arthurgritzky/Greifer/Dokumentation/Auslegung Greifer.pdf

# Auslegung Greifer

Aufgabe

Ein Roboter soll Werkstücke von dem Pufferförderband auf zwei Förderbänder einer Produktionsanlage aufteilen wie in Abbildung 1. skizziert wurde.

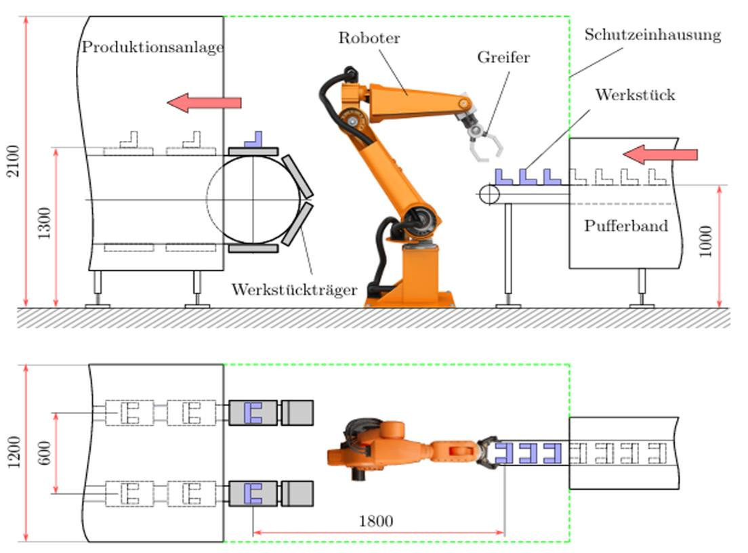
[picture p6: figure]
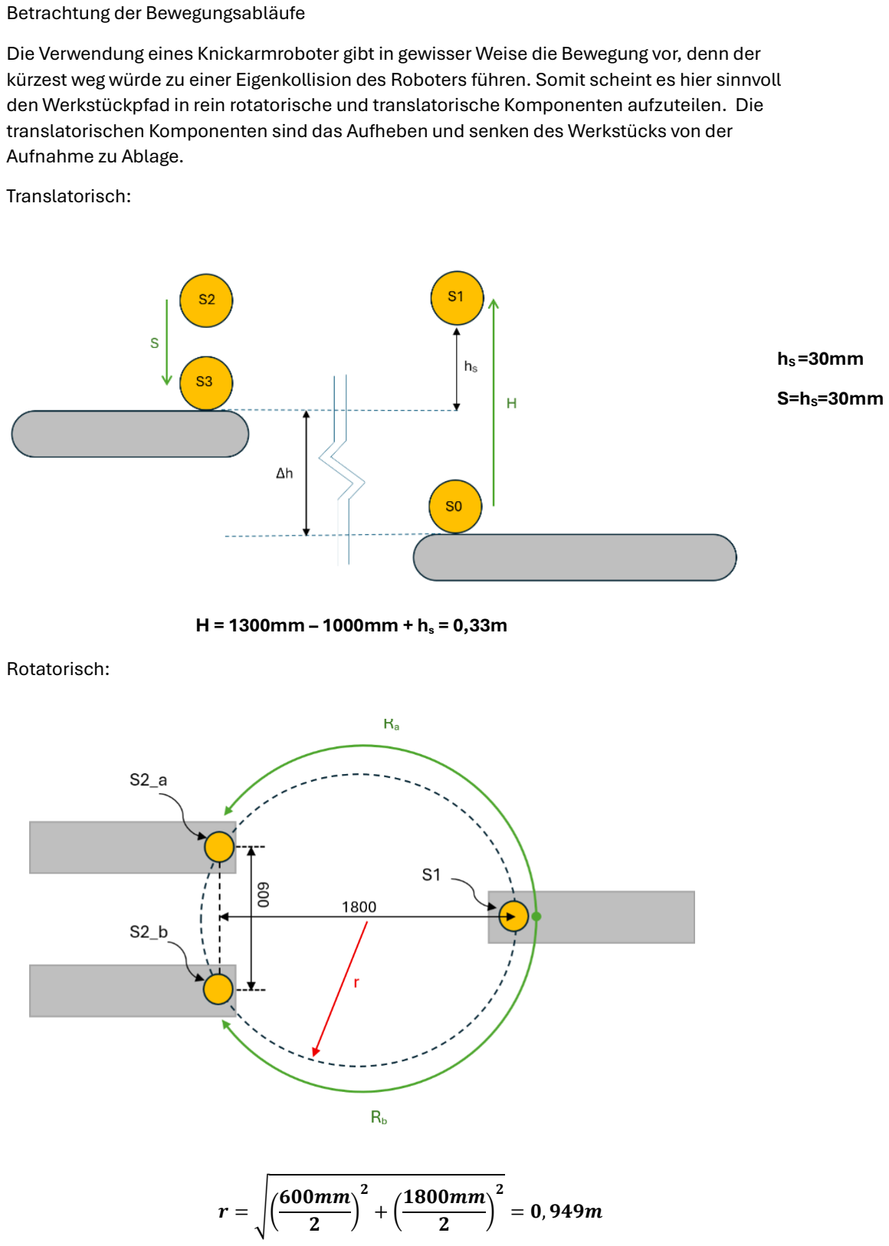
[picture p7: page 2]

Betrachtung der Bewegungsabläufe
Die Verwendung eines Knickarmroboter gibt in gewisser Weise die Bewegung vor, denn der kürzest weg würde zu einer Eigenkollision des Roboters führen. Somit scheint es hier sinnvoll den Werkstückpfad in rein rotatorische und translatorische Komponenten aufzuteilen. Die translatorischen Komponenten sind das Aufheben und senken des Werkstücks von der Aufnahme zu Ablage.
Translatorisch:

Rotatorisch:

r = √(
600mm
2

)

2
+ (

1800mm
2

)

2
= 0, 949m

hS =30mm
S=hS=30mm

H = 1300mm – 1000mm + hs = 0,33m

Greifkonzept

Das vorliegende Greiferkonzept ist speziell für das sichere Handling des gezeigten Wellen bzw. Flanschteils ausgelegt. Dabei bildet der Formschluss das Wirkprinzip des Greifvorgangs. Somit wird das Werkstück durch einen Formschluss gehalten und es bedarf keiner Reibkräfte für das Anheben. Rein die Form der Backen fixieren das Werkstück. Die Geometrien von Werkstück zu Greifer bilden einen Formschluss.

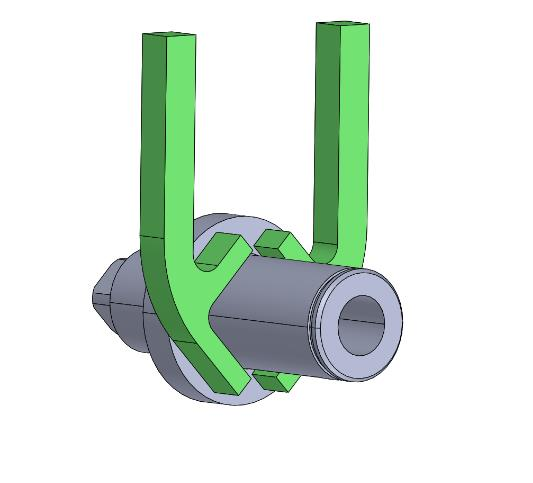
[picture p8: figure]

Konstruktiv wird dies durch einen Prismengreifer gelöst. Die im 3D-Modell grün dargestellten v-förmigen Greiferarme. Diese Klauen besitzen einen Öffnungswinkel von 90. Diese Prismenform ist für zylindrische Bauteile sehr effektiv, denn beide Greiferbacken umschließen das wellenförmige Werkstück. Durch die schrägen Flächen der 90°-Klauen wird das Werkstück beim Zugreifen automatisch exakte in der Mitte zentriert. Der Angriffspunkt wurde nahe dem Schwerpunkt des Werkstückes gewählt. Die Backen greifen den zylindrischen Schaft des Bauteils an, der sich passgenau zwischen dem vorderen Zapfen und dem dickeren Flansch befindet.
Masse Werkstück

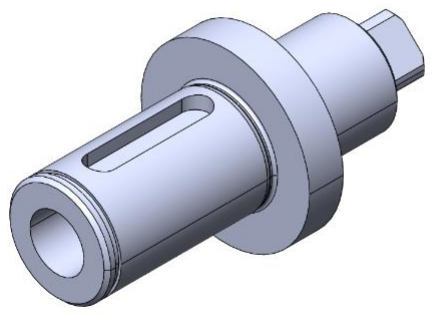
[picture p9: figure]
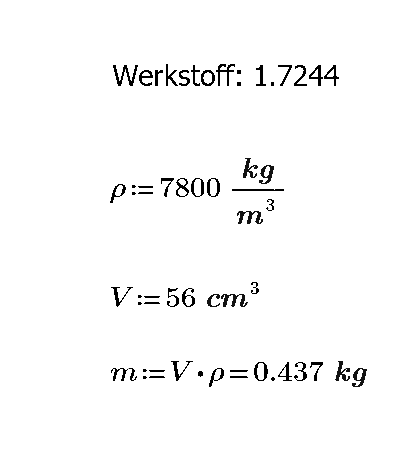
[picture p10: figure]

### Lastfälle

Beim Transport des Werkstücks vom Pufferband zur Produktionsanlage treten unterschiedliche Lastfälle auf.
Die Belastungen unterscheiden sich insbesondere zwischen dem Anheben des Werkstücks, dem anschließenden Schwenken zum Ablageband sowie dem kontrollierten Ablegen. Die Beschleunigungen, die auf das Werkstück wirken ergeben sich aus der Simulation, welche durch die Taktzeit vorgeben ist.

Lastfall 1 [Anheben]:

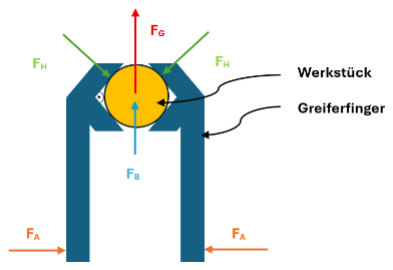
[picture p11: figure]
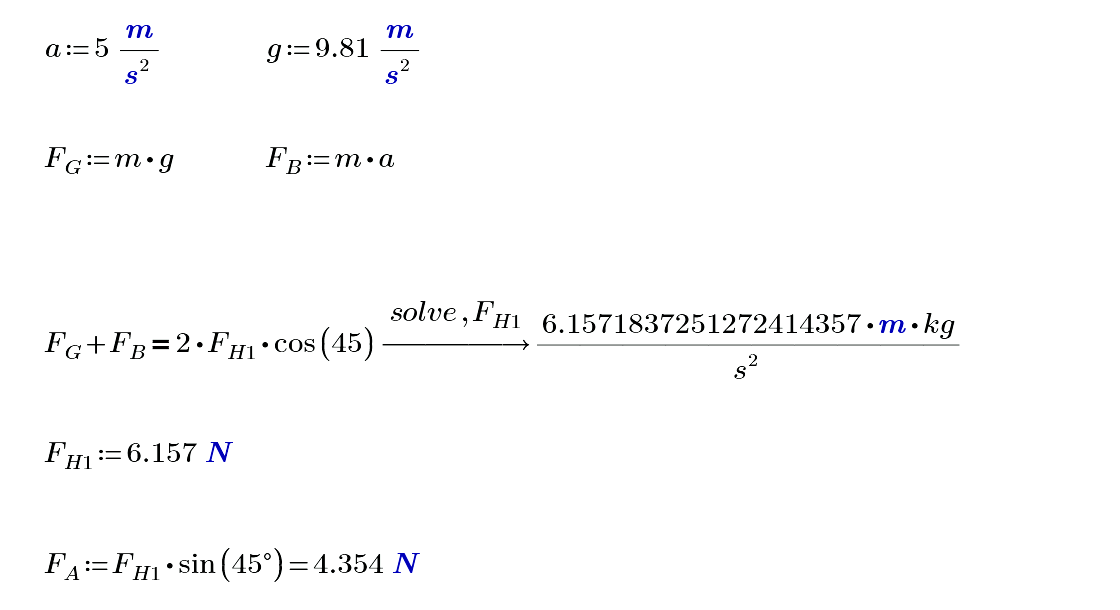
[picture p12: figure]

Lastfall 2 [Schwenken]:

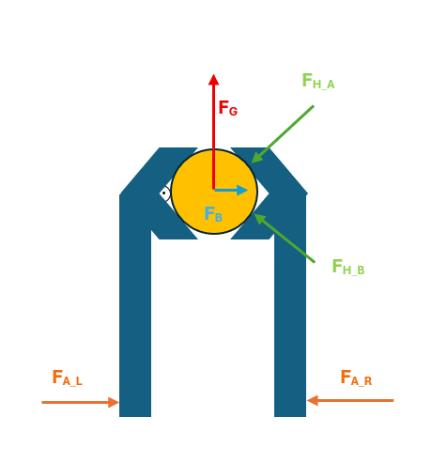
[picture p13: figure]
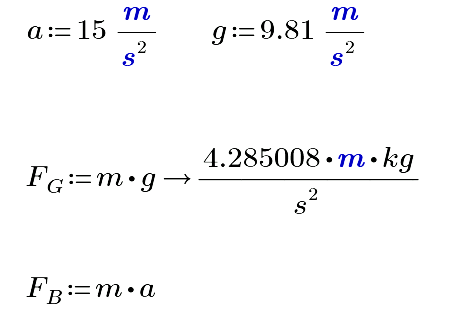
[picture p14: figure]
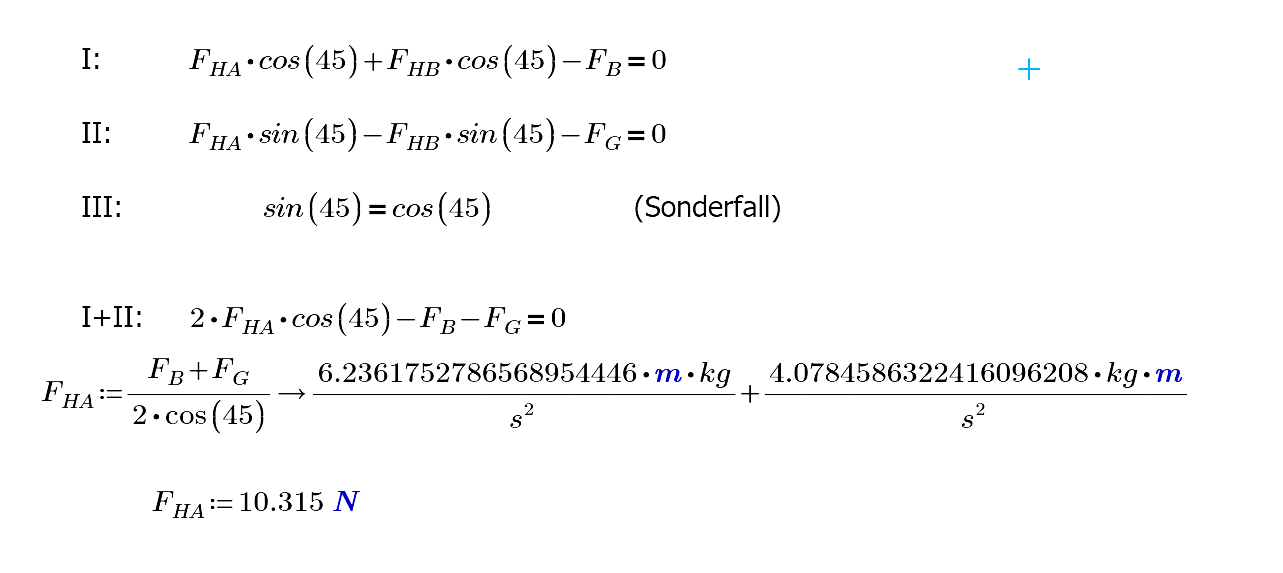
[picture p15: figure]
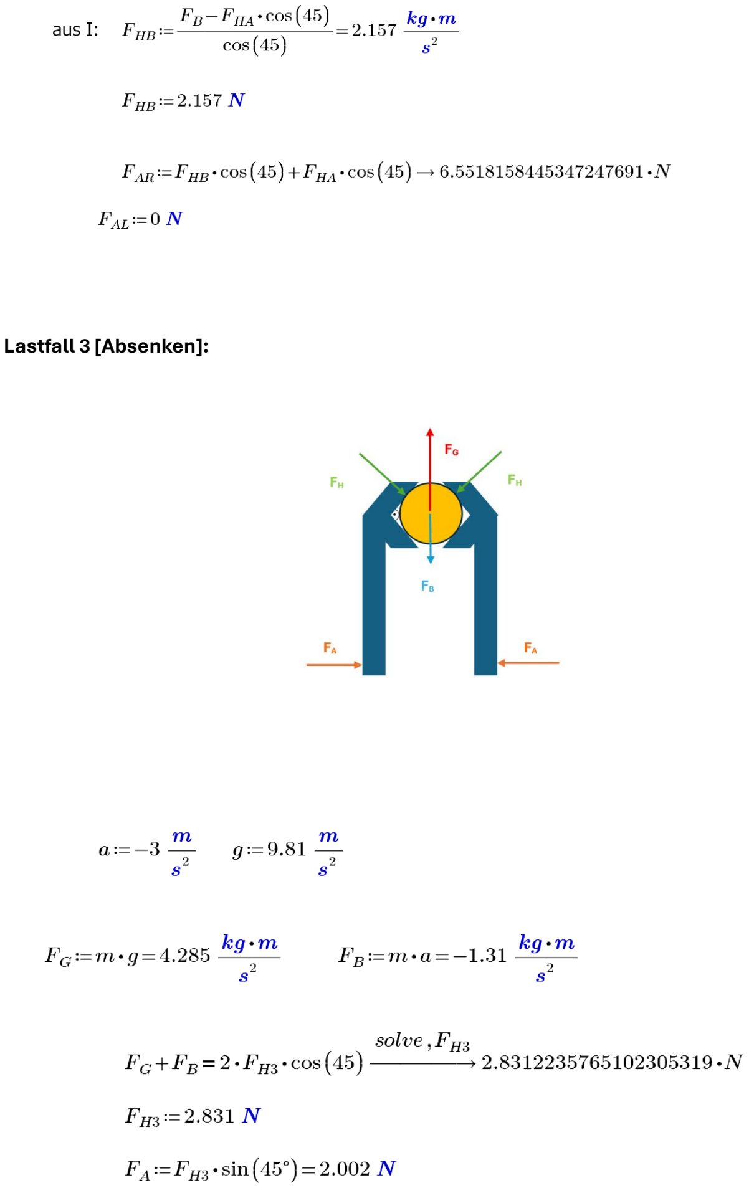
[picture p16: page 6]

Lastfall 3 [Absenken]:

### Finite Elemente Analyse

Es ist zu erkennen das der Lastfall zwei das Schwenken der kritische Lastfall ist da sich, die größte Kraft auf nur einen der Finger auswirkt, mit dem größten Betrag, dies ist der Kreisbewegung geschuldet die dadurch entstehende Zentrifugalbeschleunigung

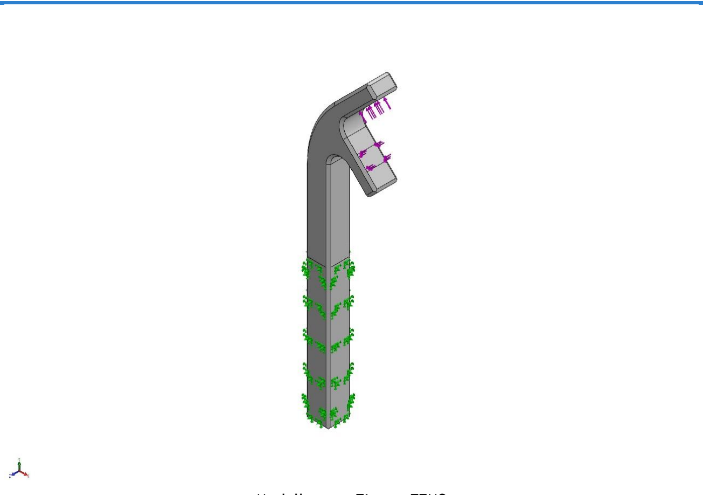
[picture p17: figure]

Modellname: Finger_FEM2
Aktuelle Konfiguration: Default
Volumenkörper
Dokumentname und Referenz | Behandelt als | Volumetrische Eigenschaften | Dokumentpfad/Datum der Änderung

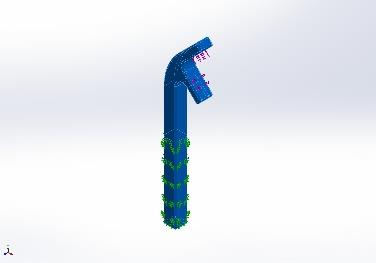
[picture p18: figure]

Cut-Extrude4 | Volumenkörper | Masse:0,0144256 kg Volumen:1,41427e-05 m^3 Dichte:1 020 kg/m^3 Gewicht:0,14137 N | C:\Users\arthur\OneDrive\F H\PDE\CAD\Finger_FEM2.SL DPRT

Studienname | Statisch 1
Analyseart | Statisch
Vernetzungstyp | Volumenkörpervernetzung
Thermische Auswirkung: | Ein
Wärmeoption | Temperaturbelastung berücksichtigen
Temperatur bei Nulldehnung | 298 Kelvin
Flüssigkeitsdruckauswirkungen von SOLIDWORKS Flow Simulation einbeziehen | Aus
Solver-Typ | Automatisch
Inplane-Auswirkung: | Aus
Soft Spring: | Aus
Massenträgheitsentlastung: | Aus
Inkompatible Verbindungsoptionen | Automatisch
Große Verschiebung | Aus
Freie Körperkräfte berechnen | Ein
Reibung | Aus
Adaptionsmethode verwenden: | Aus
Einheitensystem: | SI (MKS)
Länge/Verschiebung | mm
Temperatur | Kelvin
Winkelgeschwindigkeit | rad/s
Druck/Spannung | N/m^2

Modellreferenz | Eigenschaften
| Name: ABS Modelltyp: Linear Elastisch Isotrop Standardversagenskrit erium: Unbekannt
| Zugfestigkeit: 3e+07 N/m^2 Elastizitätsmodul: 2e+09 N/m^2 Poissonsche Zahl: 0,394 Massendichte: 1 020 kg/m^3 Schubmodul: 3,189e+08 N/m^2

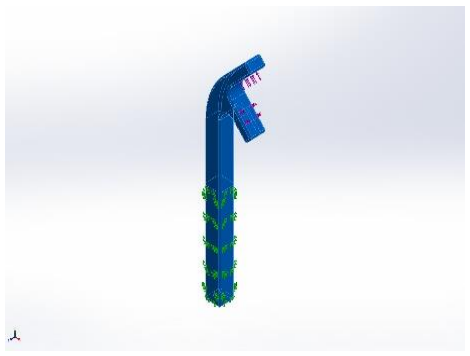
[picture p19: figure]

Kurvendaten:N/A

Einspannungsna
me
Einspannungsbild | Einspannungsdetails

Fixiert-1

Elemente: 4 Flächen
Typ: Fixierte
Geometrie

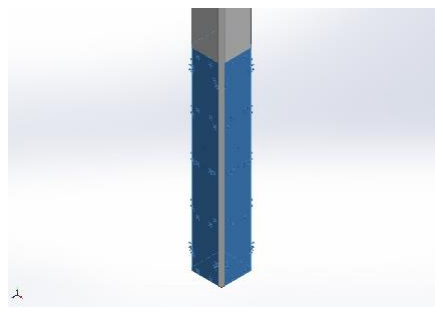
[picture p20: figure]

Resultierende Kräfte
Komponenten | X | Y | Z | Resultierend
Reaktionskraft(N) | 8,8247 | -5,76997 | -1,41433e-06 | 10,5436
Reaktionsmoment(N.m) | 0 | 0 | 0 | 0

Lastdetails (Lastfall 2)

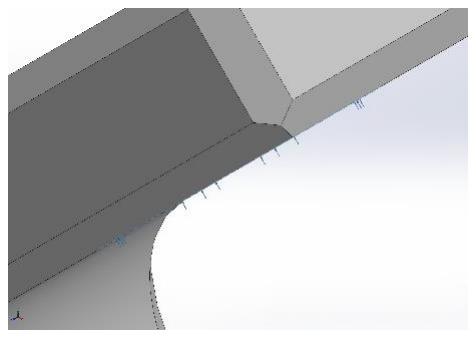
[picture p21: figure]

Kraft-1

Elemente: 1 Fläche(n)
Typ: Normalkraft
anwenden
Wert: 10,32 N

Kraft-2

Elemente: 1 Fläche(n)
Typ: Normalkraft
anwenden
Wert: 2,16 N

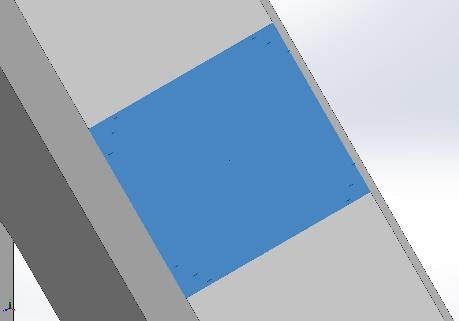
[picture p22: figure]

Vernetzungstyp | Volumenkörpervernetzung
Verwendeter Vernetzungstyp: | Gemischtes kurvengestütztes Netz
Jacobi-Punkte für Vernetzung hoher Qualität | 16 Punkte
Maximale Elementgröße | 2,4192 mm
Minimale Elementgröße | 2,4192 mm
Netzqualität | Hoch
Gesamtknotenanzahl | 17121
Gesamtelementanzahl | 10738
Maximales Seitenverhältnis | 490,82
% von Elementen mit Seitenverhältnis < 3 | 99,1
Prozentsatz Elemente mit Seitenverhältnis > 10 | 0,745
Prozentsatz verzerrte Elemente | 0
Dauer bis zur Beendigung der Vernetzung (hh;mm;ss): | 00:01:12

Computer-Name:

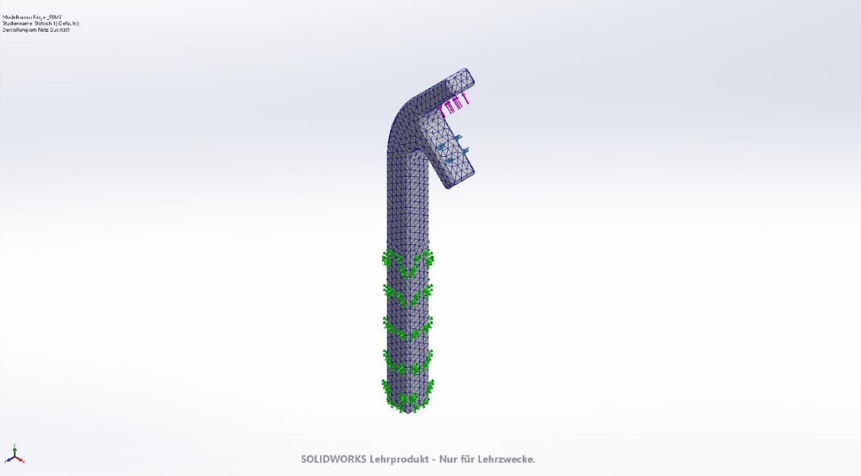
[picture p23: figure]

# Resultierende Kräfte

## Reaktionskräfte

Auswahlsatz | Maßeinheiten | Summe X | Summe Y | Summe Z | Resultierend
Gesamtes Modell | N | 8,8247 | -5,76997 | -1,41433e-06 | 10,5436

## Reaktionsmomente

Auswahlsatz | Maßeinheiten | Summe X | Summe Y | Summe Z | Resultierend
Gesamtes Modell | N.m | 0 | 0 | 0 | 0

## Freie Körperkräfte

Auswahlsatz | Maßeinheiten | Summe X | Summe Y | Summe Z | Resultierend
Gesamtes Modell | N | 6,85341e-06 | 7,29346e-06 | -1,47492e-06 | 1,01163e-05

## Freie Körpermomente

Auswahlsatz | Maßeinheiten | Summe X | Summe Y | Summe Z | Resultierend
Gesamtes Modell | N.m | 0 | 0 | 0 | 1e-33

Name | Typ | Min. | Max.
Spannung1 | VON: Von-Mises-Spannung | 4,763e-02N/m^2 Knoten: 11359 | 5,711e+06N/m^2 Knoten: 55

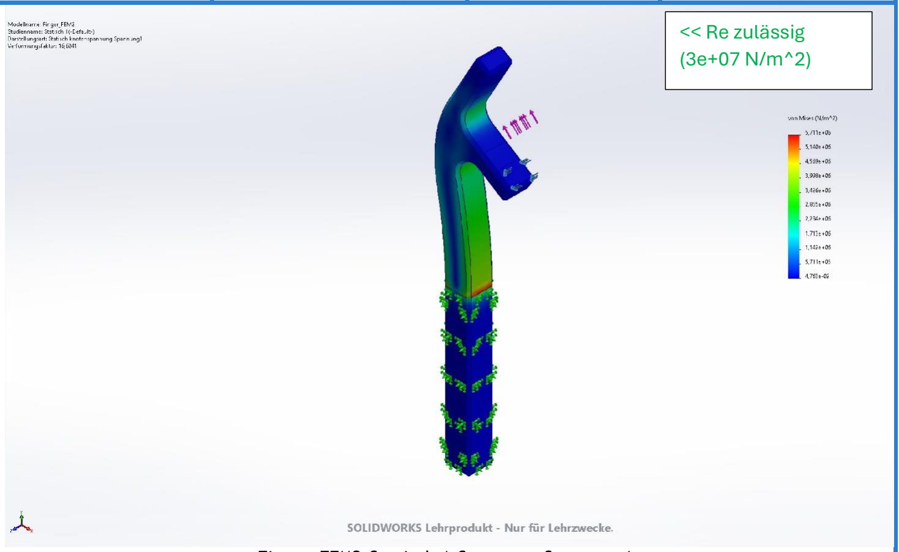
[picture p24: figure]
<< Re zulässig (3e+07 N/m^2)

Finger_FEM2-Statisch 1-Spannung-Spannung1

Name | Typ | Min. | Max.
Verschiebung1 | URES: Resultierende Verschiebung | 0,000e+00mm Knoten: 9 | 8,833e-01mm Knoten: 12020

Name | Typ | Min. | Max.

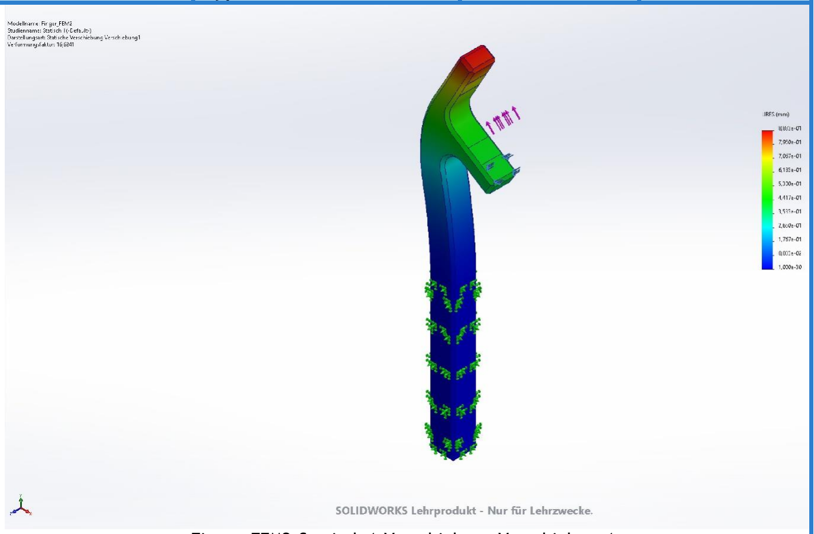
[picture p25: figure]

Finger_FEM2-Statisch 1-Verschiebung-Verschiebung1

Name | Typ | Min. | Max.
Dehnung1 | ESTRN: Äquivalente Dehnung | 1,967e-11 Element: 1158 | 2,500e-03 Element: 5946

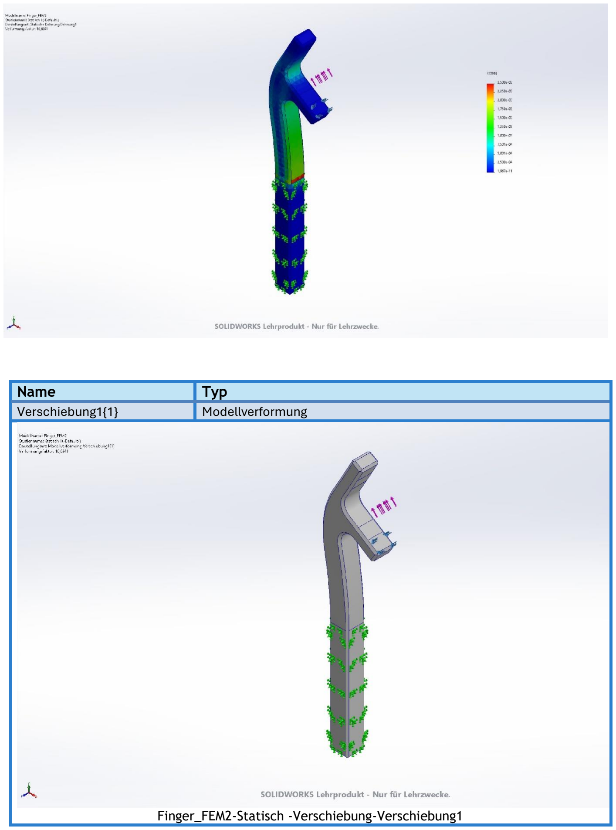
[picture p26: page 14]

Name | Typ
Verschiebung1{1} | Modellverformung

Finger_FEM2-Statisch -Verschiebung-Verschiebung1

Bewertung

Die maximale von-Mises-Spannung beträgt:

σmax = 5,71 MPa

Die im Material hinterlegte Zugfestigkeit von ABS liegt bei:

σzul = 30 MPa

Damit wird die zulässige Spannung deutlich unterschritten. Die maximale auftretende Spannung beträgt nur etwa 19 % der Zugfestigkeit.

Es ergibt sich somit ein Sicherheitsfaktor von ungefähr:

S ≈

30
5,71 ≈ 5,3

Der Greiferfinger ist damit unter den angesetzten Lasten mechanisch klar ausreichend dimensioniert.

Verformungsverhalten

Die maximale resultierende Verschiebung beträgt:

umax = 0,883 mm

Diese Verschiebung tritt an der Spitze des Fingers auf und ist für einen Kunststoffbauteil dieser Geometrie und Belastung als gering einzustufen.

Die äquivalente Dehnung liegt mit maximal:

εmax = 2,5 × 10⁻³

ebenfalls im unkritischen Bereich.

Die Verformung beeinflusst die Greiffunktion nicht nennenswert. Es ist weder mit einer relevanten Änderung der Greifgeometrie noch mit Funktionsbeeinträchtigungen zu rechnen. Das Werkstück sollte laut diesen nicht herausrutschen bzw. die Finger der Belastung Standhalten.

Motorauslegung

Der Antrieb des Backengreifers erfolgt über einen Schrittmotor, dessen Drehbewegung über eine Zahnradstufe auf eine Trapezgewindespindel übertragen wird. Das Motorritzel mit Z₁ = 23 Zähnen treibt ein Zahnrad mit Z₂ = 40 Zähnen an, welches fest mit der Gewindespindel verbunden ist. Durch diese Zahnradübersetzung wird die Drehzahl reduziert und das Drehmoment erhöht. Die Gewindespindel wandelt die Drewegung anschließend in eine lineare Verschiebung der Greiferbacken um. Die verwendete Trapezgewindespindel besitzt eine Steigung von p = 8 mm pro Umdrehung.

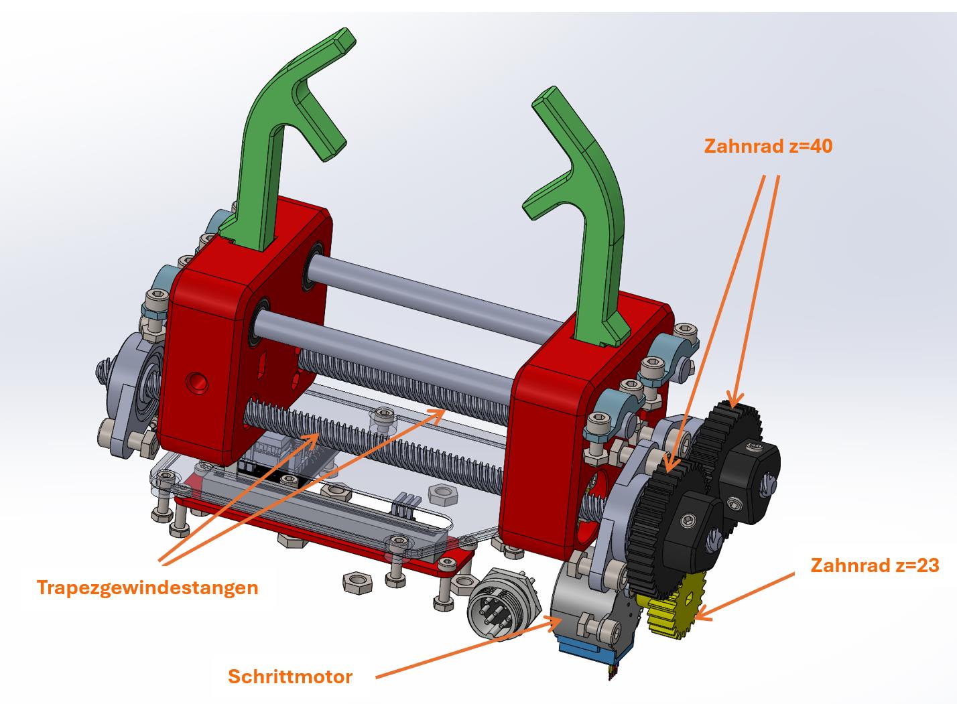
[picture p27: figure]

Gegeben:

- | Zähnezahl Motorritzel: | Z₁ = 23
- | Zähnezahl Spindelzahnrad: | Z₂ = 40
- | Gewindesteigung: | p = 8 mm/U
- | Gewünschte Backenkraft: | F = 10.32 N (Lastfall 1)
1) Zahnradübersetzung

i =

Z2
Z1

i =

40
23 = 1.739

Bedeutung:

- | Drehzahlreduktion: | nSpindel = 0.575 ⋅ nMotor
- Drehmomentverstärkung: MSpindel = 1.739 ⋅ MMotor
2) Linearweg pro Motorumdrehung

Spindelweg pro Umdrehung:

sSpindel = 8 mm/U

Spindelumdrehungen pro Motorumdrehung:

Z1
Z2

=

23
40 = 0.575

Linearweg pro Motorumdrehung:

sMotor = 8 ⋅

23
40
sMotor = 4.6 mm/U
3) Erforderliches Drehmoment an der Spindel (ideal)

Zusammenhang Spindelkraft ↔ Drehmoment:

Mideal =

F ⋅ p
2π

Mideal =

10.32 ⋅ 0.008
2π
Mideal = 0.0131 N\m
4) Berücksichtigung des Wirkungsgrades der Spindel

Typischer Wirkungsgrad Trapezgewinde:

ηSpindel ≈ 0.25 – 0.35

Für konservative Auslegung (η = 0.30):

MSpindel =

Mideal
ηSpindel

MSpindel =

0.0131
0.30
MSpindel = 0.0438 N\m
5) Erforderliches Motordrehmoment

Unter Annahme Zahnradwirkungsgrad:

ηZahnrad ≈ 0.95

MMotor =

MSpindel
i ⋅ ηZahnrad

MMotor =

0.0438
1.739 ⋅ 0.95
MMotor = 0.0265 N\m

Die vorangegangene Drehmomentberechnung dient ausschließlich der sicherheitstechnischen Auslegung des Antriebssystems. Sie berücksichtigt den theoretisch ungünstigsten Fall, in dem der Antrieb aktiv die vollständige Greifkraft aufbringen muss.

In der praktischen Anwendung ist jedoch zu beachten, dass die verwendeten Trapezgewindespindeln aufgrund ihres geringen Steigungswinkels selbsthemmend wirken. Dadurch sind die Greiferbacken nach Erreichen der Zielposition mechanisch blockiert.

Gewählter Motor

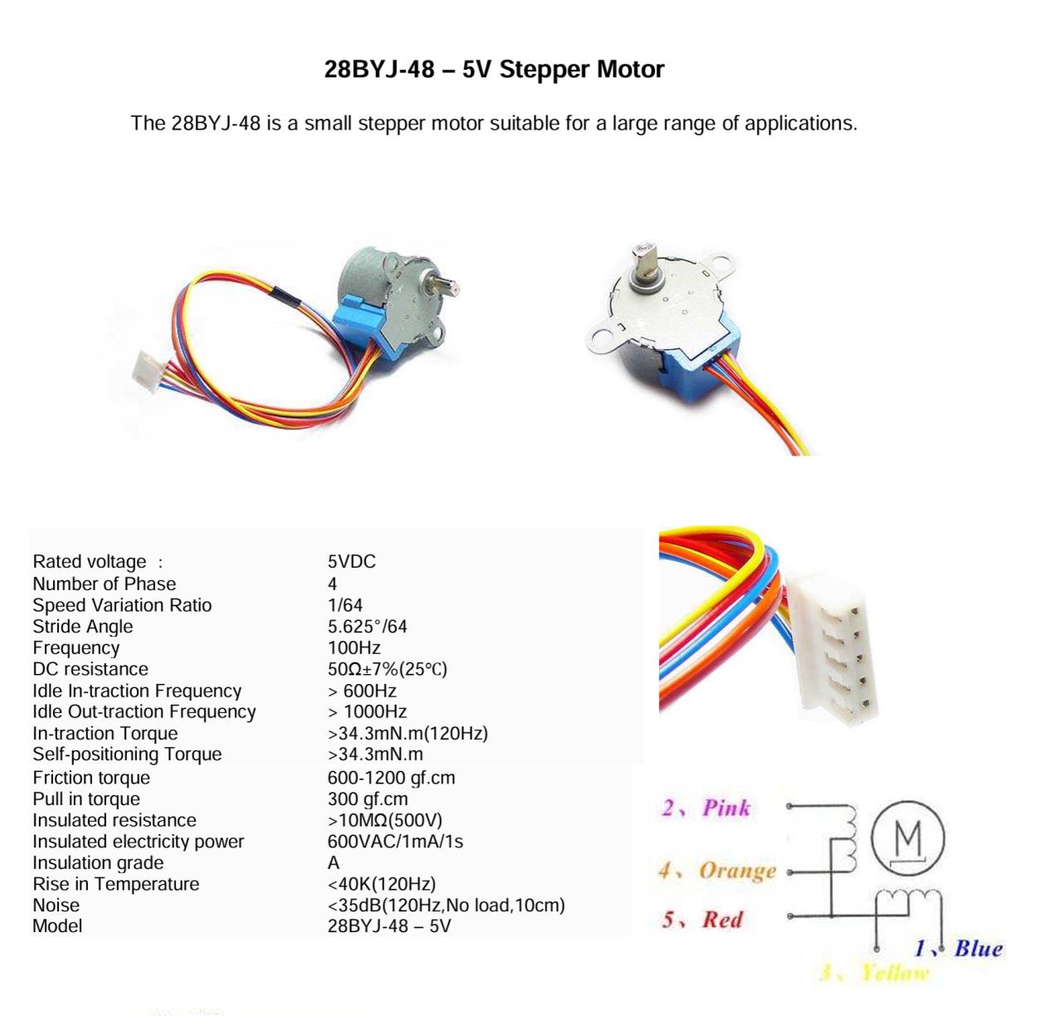
[picture p28: figure]

### Elektronik

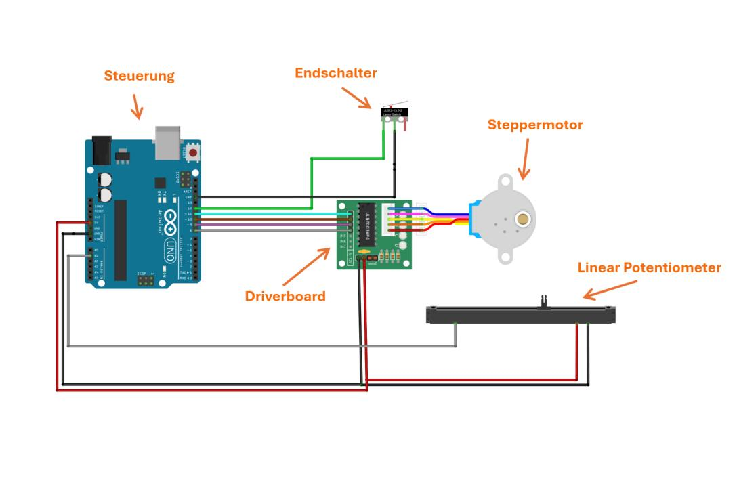
[picture p29: figure]

Das Steuerungs und Sicherheitskonzept des Backengreifers basiert auf einer Referenzfahrt beim Systemstart, der schrittbasierten Positionsbestimmung des Schrittmotors sowie einer zusätzlichen sicherheitstechnischen Positionsüberwachung mittels linearem Potentiometer. Nach dem Einschalten des Systems wird zunächst eine Referenzfahrt durchgeführt. Dabei fahren die Greiferbacken auseinander, bis der Endschalter betätigt wird. Diese Position definiert die eindeutig reproduzierbare Homingposition und stellt die mechanische Referenz des Systems dar. Durch das Anfahren des Endschalters wird die interne Schrittposition des Schrittmotors auf Null gesetzt, wodurch eine definierte Ausgangslage für alle weiteren Bewegungen geschaffen wird. Nach Abschluss dieser Referenzfahrt kennt die Steuerung die aktuelle Position der Greifermechanik.
Die anschließende Positionssteuerung erfolgt primär über die gezählten Motorschritte. Da die Anzahl der erforderlichen Schritte zwischen der Homingposition und der gewünschten Greifposition bekannt ist, kann die Zielposition rechnerisch bestimmt und präzise angefahren werden. Der Schrittmotor ermöglicht somit eine reproduzierbare und genaue Positionierung der Greiferbacken, ohne dass hierfür eine kontinuierliche Positionsrückmeldung erforderlich ist. Zur zusätzlichen Absicherung des Systems ist ein lineares Potentiometer integriert, das die tatsächliche mechanische Position der Greiferbacken erfasst. Dieses dient ausschließlich sicherheitstechnischen Zwecken und übernimmt keine aktive Regelungsfunktion. Die gemessene Position wird verwendet, um zu überprüfen, ob die berechnete Zielposition tatsächlich erreicht wurde. Dadurch können mögliche Abweichungen, beispielsweise durch Schrittverluste des Motors, mechanische Blockaden oder andere Störungen, erkannt werden. Das Potentiometer stellt somit eine unabhängige Positionsüberwachung dar und erhöht die Zuverlässigkeit des Gesamtsystems.
Durch die Kombination aus Referenzfahrt, schrittbasierter Positionsbestimmung und externer Positionsüberwachung wird ein robustes und fehlertolerantes Steuerungskonzept realisiert. Im Falle einer erkannten Positionsabweichung kann die Steuerung geeignete Maßnahmen einleiten, wie etwa einen Bewegungsstopp, eine erneute Referenzfahrt oder die Ausgabe einer Fehlermeldung. Auf diese Weise wird sowohl eine präzise Positionierung als auch eine erhöhte Betriebssicherheit des Greifers gewährleistet.
