arthurgritzky/Greifer/CAD/Bauteil_D.SLDPRT

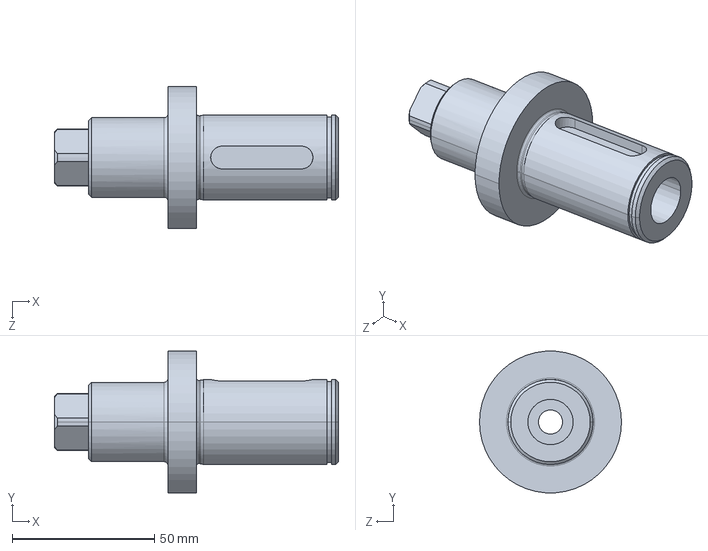
[picture p30: CAD file, 2026-02-12]
CAD/Bauteil_D.SLDPRT
100.0 x 49.9 x 50.0 mm
