arthurgritzky/Greifer/CAD/Potentiometer.SLDPRT

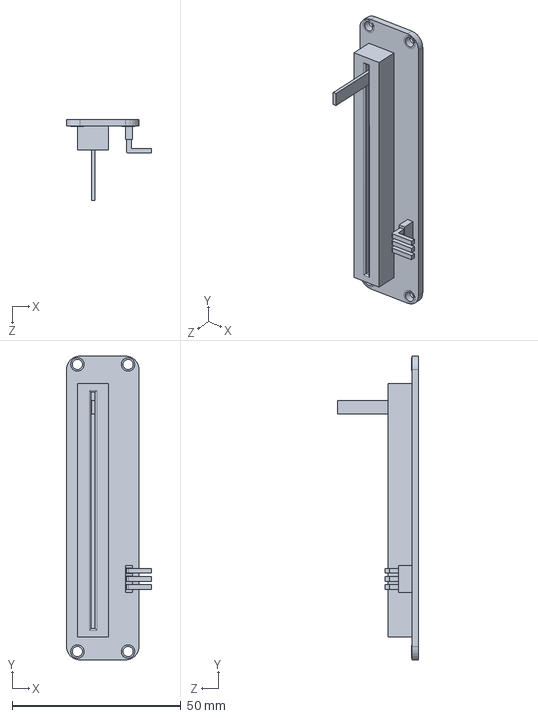
[picture p31: CAD file, 2026-02-12]
CAD/Potentiometer.SLDPRT
25.2 x 90.0 x 24.0 mm
