arthurgritzky/Greifer/CAD/KFL08_Flanschlager.SLDPRT

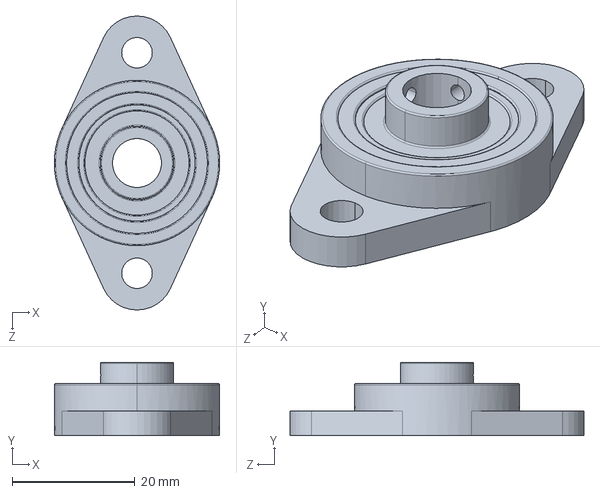
[picture p32: CAD file, 2026-02-12]
CAD/KFL08_Flanschlager.SLDPRT
27.0 x 12.0 x 48.0 mm
