arthurgritzky/Greifer/CAD/Führungsstange.SLDPRT

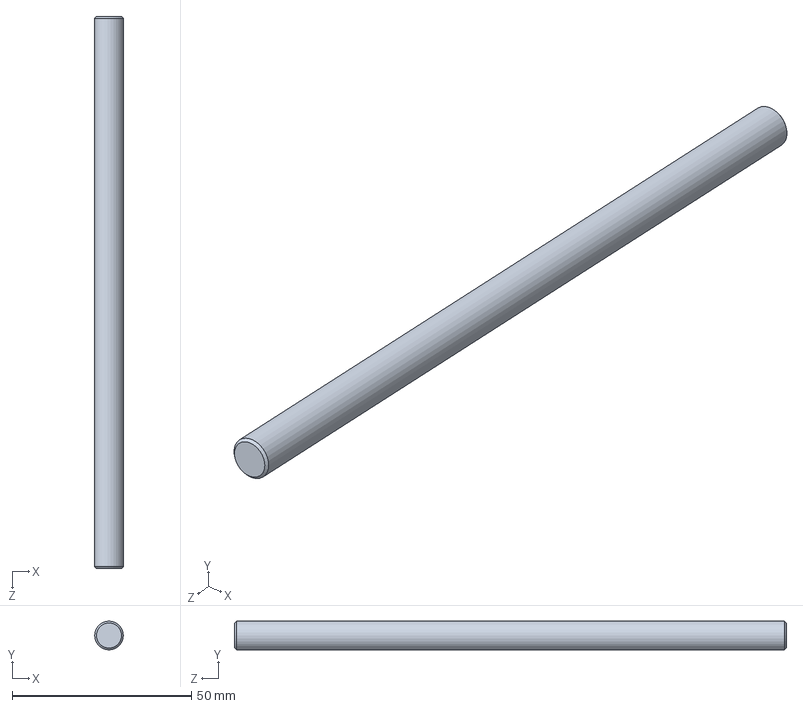
[picture p33: CAD file, 2026-02-12]
CAD/Führungsstange.SLDPRT
8.00 x 7.96 x 154.0 mm
