arthurgritzky/Greifer/CAD/28BYJ-48_Schrittmotor.SLDPRT

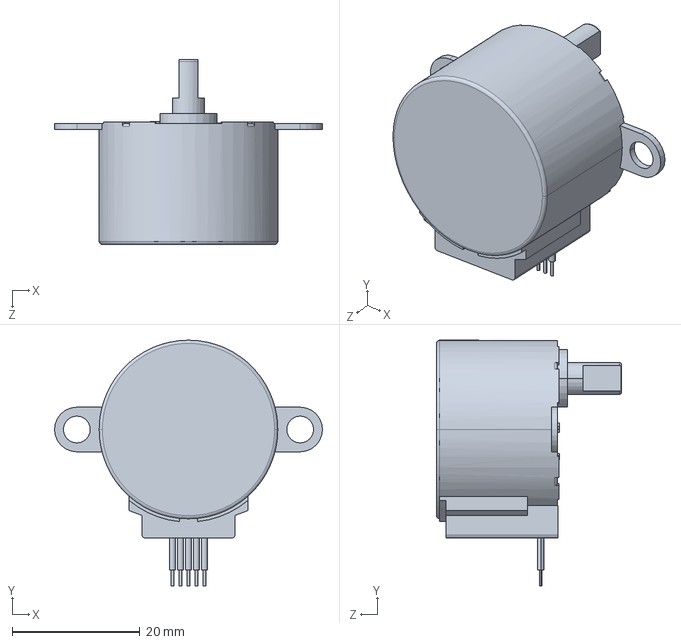
[picture p34: CAD file, 2026-02-12]
CAD/28BYJ-48_Schrittmotor.SLDPRT
42.0 x 38.5 x 29.0 mm
