arthurgritzky/Greifer/CAD/Trennplatte.SLDPRT

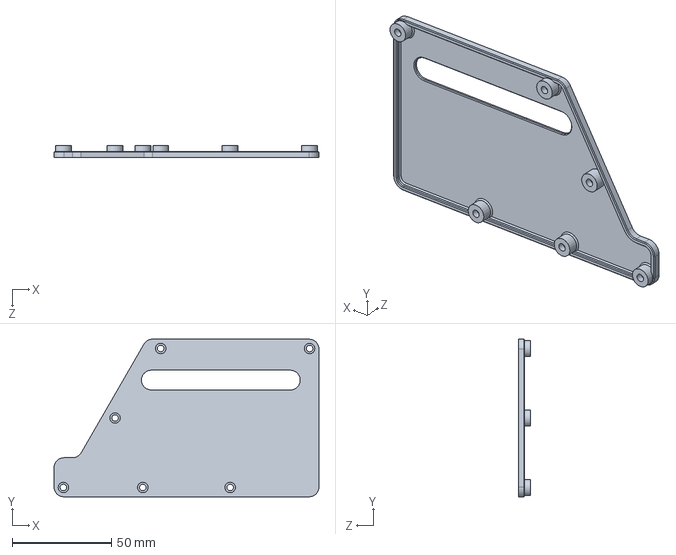
[picture p35: CAD file, 2026-02-12]
CAD/Trennplatte.SLDPRT
133.5 x 79.5 x 6.20 mm
