arthurgritzky/Greifer/CAD/T8_Gewindestange.SLDPRT

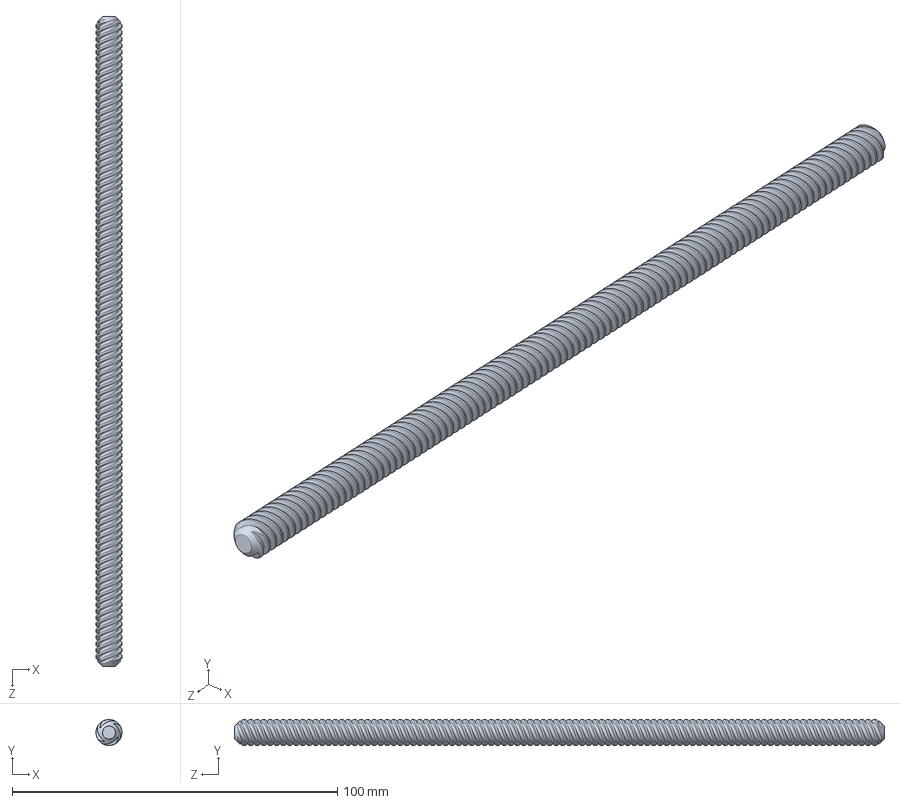
[picture p36: CAD file, 2026-02-12]
CAD/T8_Gewindestange.SLDPRT
8.00 x 8.00 x 200.0 mm
