arthurgritzky/Greifer/CAD/LM8UU_Linearlager.SLDPRT

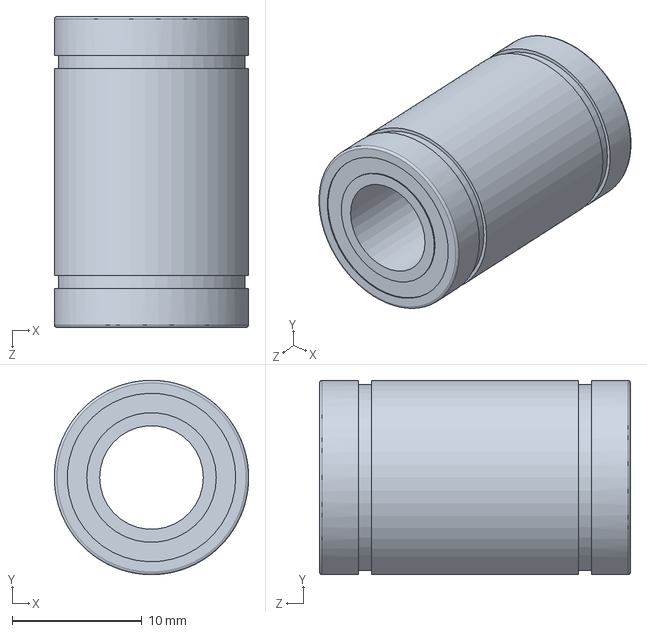
[picture p37: CAD file, 2026-02-12]
CAD/LM8UU_Linearlager.SLDPRT
15.0 x 15.0 x 24.0 mm
