arthurgritzky/Greifer/CAD/GX16_Mutter.SLDPRT

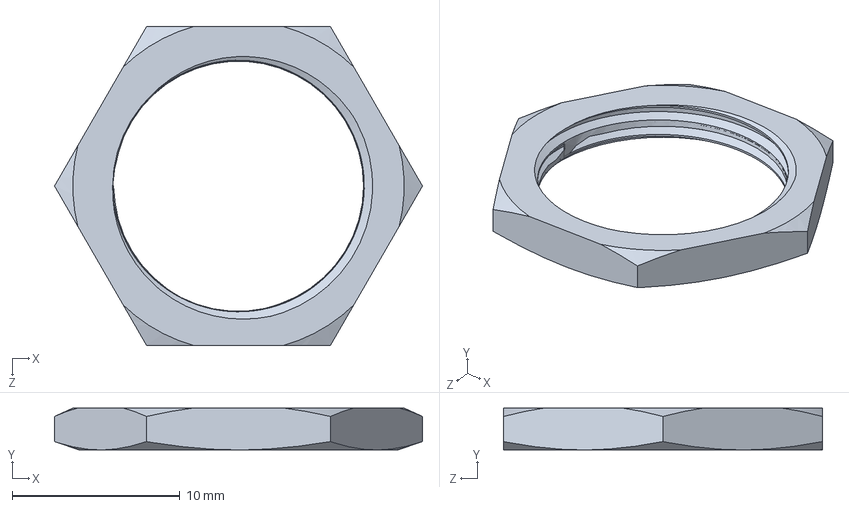
[picture p38: CAD file, 2026-02-12]
CAD/GX16_Mutter.SLDPRT
21.9 x 2.50 x 19.0 mm
