arthurgritzky/Greifer/CAD/Finger.SLDPRT

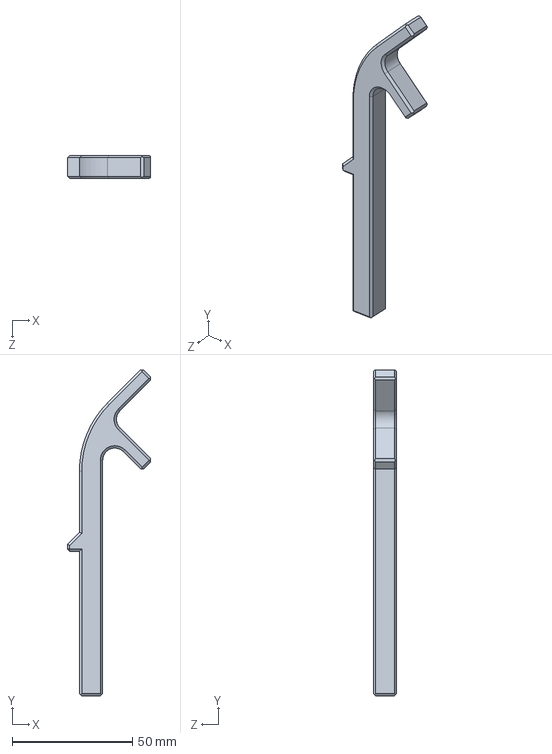
[picture p39: CAD file, 2026-02-12]
CAD/Finger.SLDPRT
34.6 x 135.4 x 9.70 mm
