arthurgritzky/Greifer/CAD/Antriebszahnrad.SLDPRT

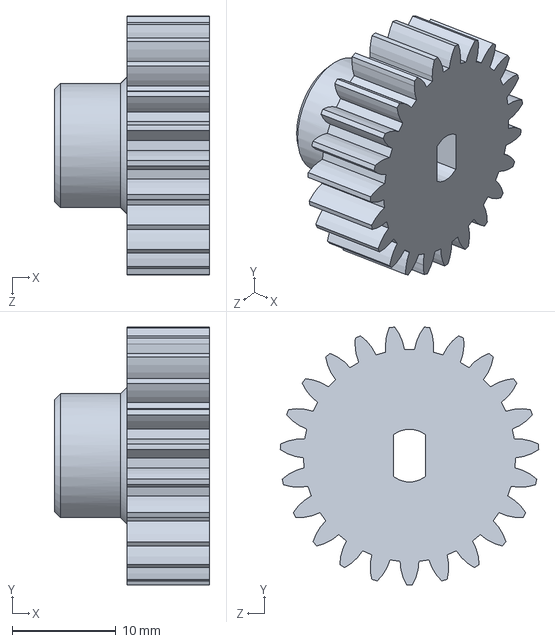
[picture p40: CAD file, 2026-02-12]
CAD/Antriebszahnrad.SLDPRT
15.0 x 24.9 x 25.0 mm
