arthurgritzky/Greifer/CAD/Halter_Führungsstange.SLDPRT

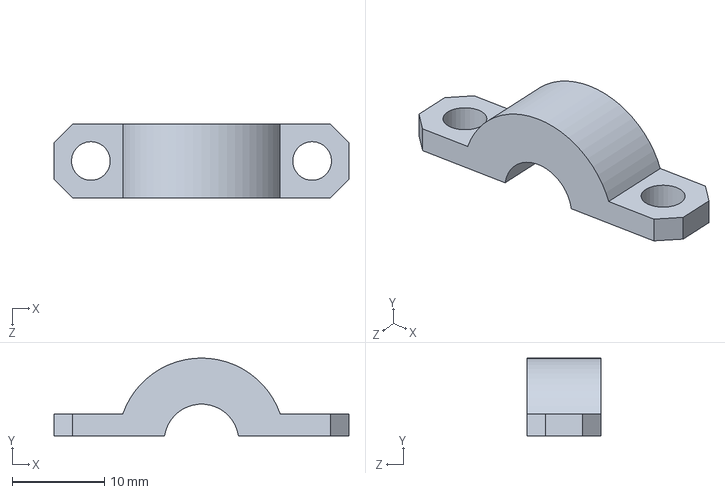
[picture p41: CAD file, 2026-02-12]
CAD/Halter_Führungsstange.SLDPRT
32.0 x 8.45 x 8.00 mm
