arthurgritzky/Greifer/CAD/T8_Mutter.SLDPRT

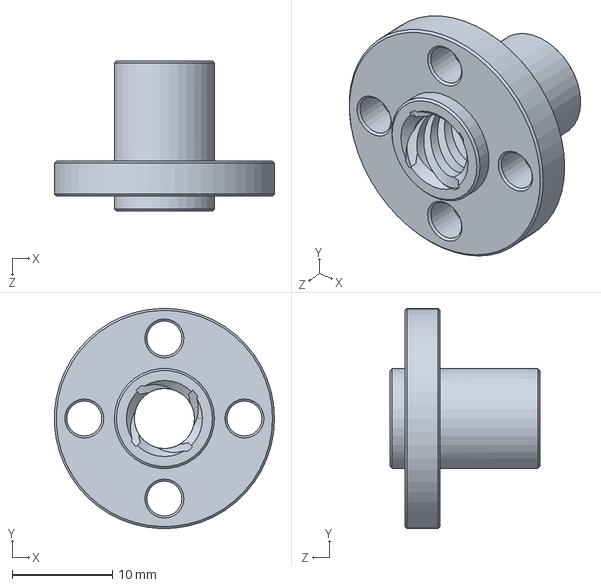
[picture p42: CAD file, 2026-02-12]
CAD/T8_Mutter.SLDPRT
22.0 x 22.0 x 15.0 mm
