arthurgritzky/Greifer/CAD/GX16-8.SLDPRT

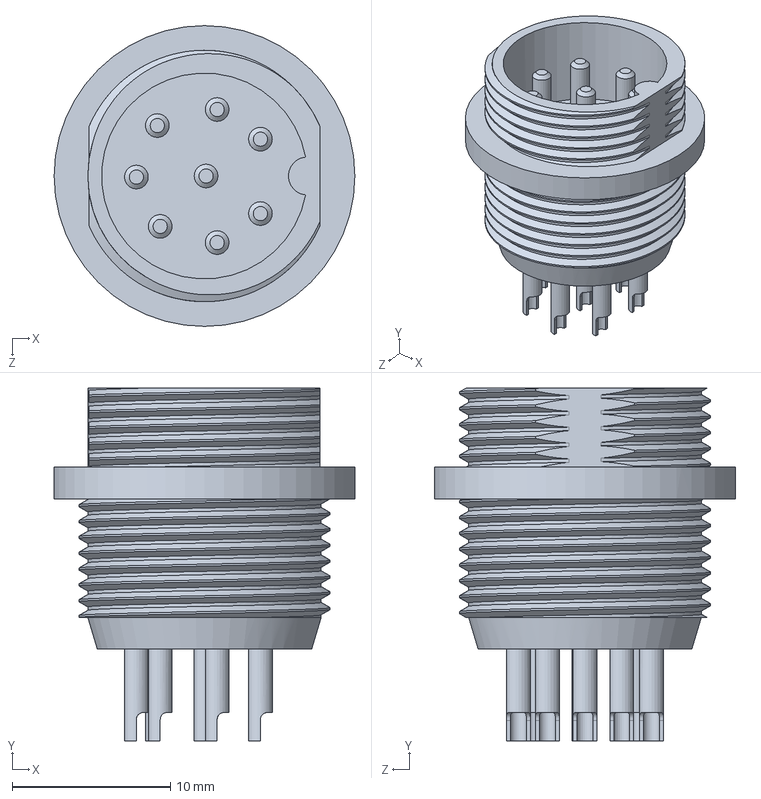
[picture p43: CAD file, 2026-02-12]
CAD/GX16-8.SLDPRT
19.0 x 22.3 x 19.0 mm
