arthurgritzky/Greifer/CAD/Endschalter.SLDPRT

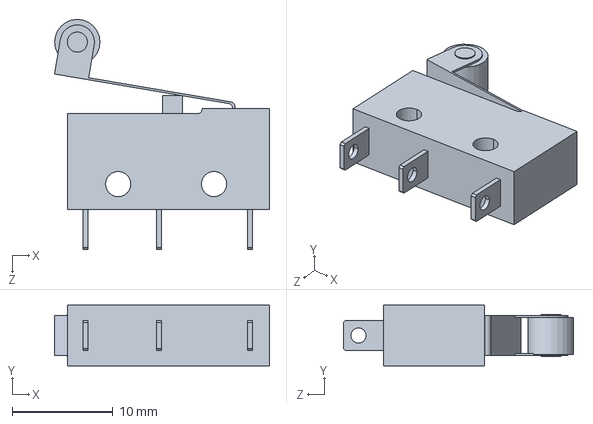
[picture p44: CAD file, 2026-02-12]
CAD/Endschalter.SLDPRT
21.3 x 6.00 x 22.8 mm
