arthurgritzky/Greifer/CAD/Zahnrad_Gewindestange.SLDPRT

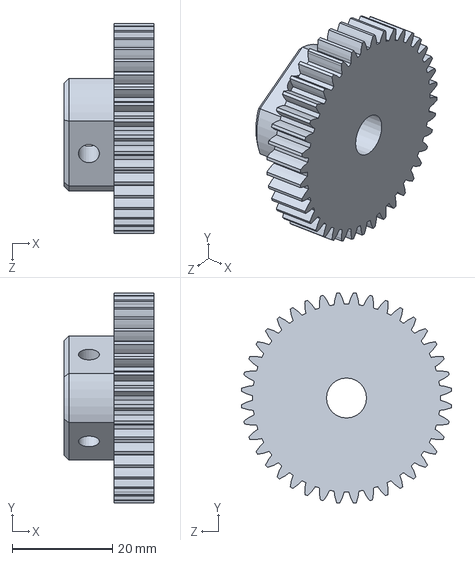
[picture p45: CAD file, 2026-02-12]
CAD/Zahnrad_Gewindestange.SLDPRT
18.0 x 41.9 x 41.9 mm
