arthurgritzky/Greifer/CAD/Gehäuse.SLDASM

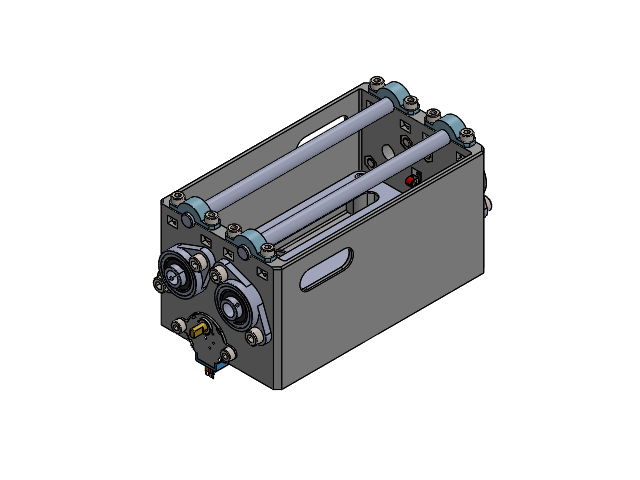
[picture p46: CAD file, 2026-02-12]
CAD/Gehäuse.SLDASM
Gehäuse
Führungsstange x 2
KFL08_Flanschlager x 4
Halter_Führungsstange x 4
socket head cap screw_din x 26
hex thin nut gradeb_din x 16
28BYJ-48_Schrittmotor
hex thin nut gradeb_iso x 10
Endschalter
Schrittmotortreiberboard
Trennplatte
hex nut style 1 gradeab_din x 14
GX16-8
GX16_Mutter
