arthurgritzky/Greifer/CAD/Antrieb.SLDASM

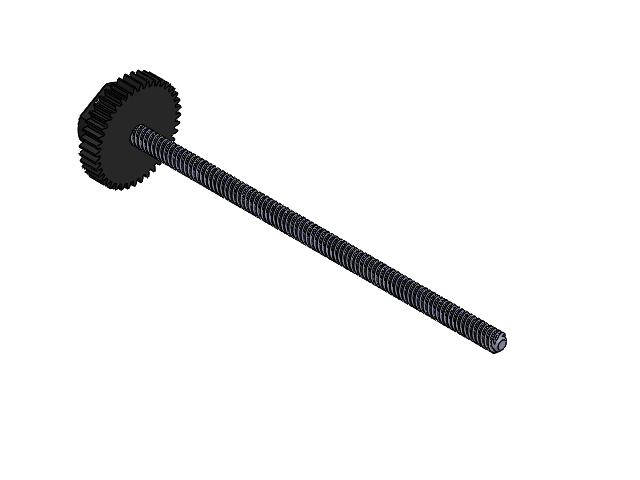
[picture p47: CAD file, 2026-02-12]
CAD/Antrieb.SLDASM
Zahnrad_Gewindestange
T8_Gewindestange
socket set screw flat point_din x 3
