arthurgritzky/Greifer/CAD/Schlitten.SLDASM

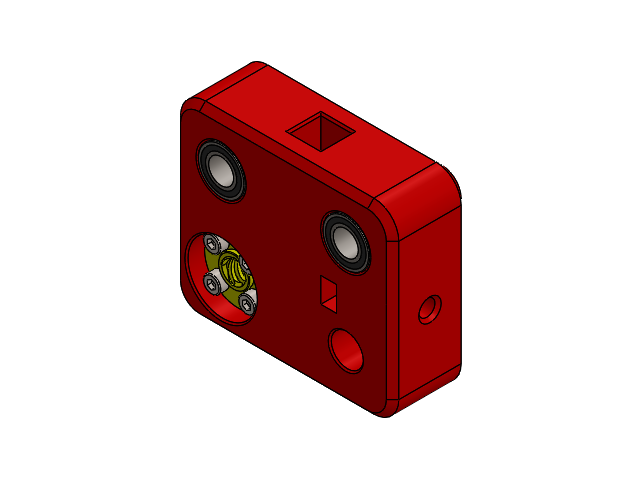
[picture p48: CAD file, 2026-02-12]
CAD/Schlitten.SLDASM
Schlitten
T8_Mutter
LM8UU_Linearlager x 2
socket head cap screw_din x 4
hex nut style 1 gradeab_din x 4
hex thin nut gradeb_iso
socket set screw flat point_din
