arthurgritzky/Greifer/(list of files, cad)

Other CAD files:
CAD/Gehäuse.SLDPRT
CAD/Schlitten.SLDPRT
