arthurgritzky/Greifer/Baugruppenzeichnung/Baugruppe.pdf

E E

F F

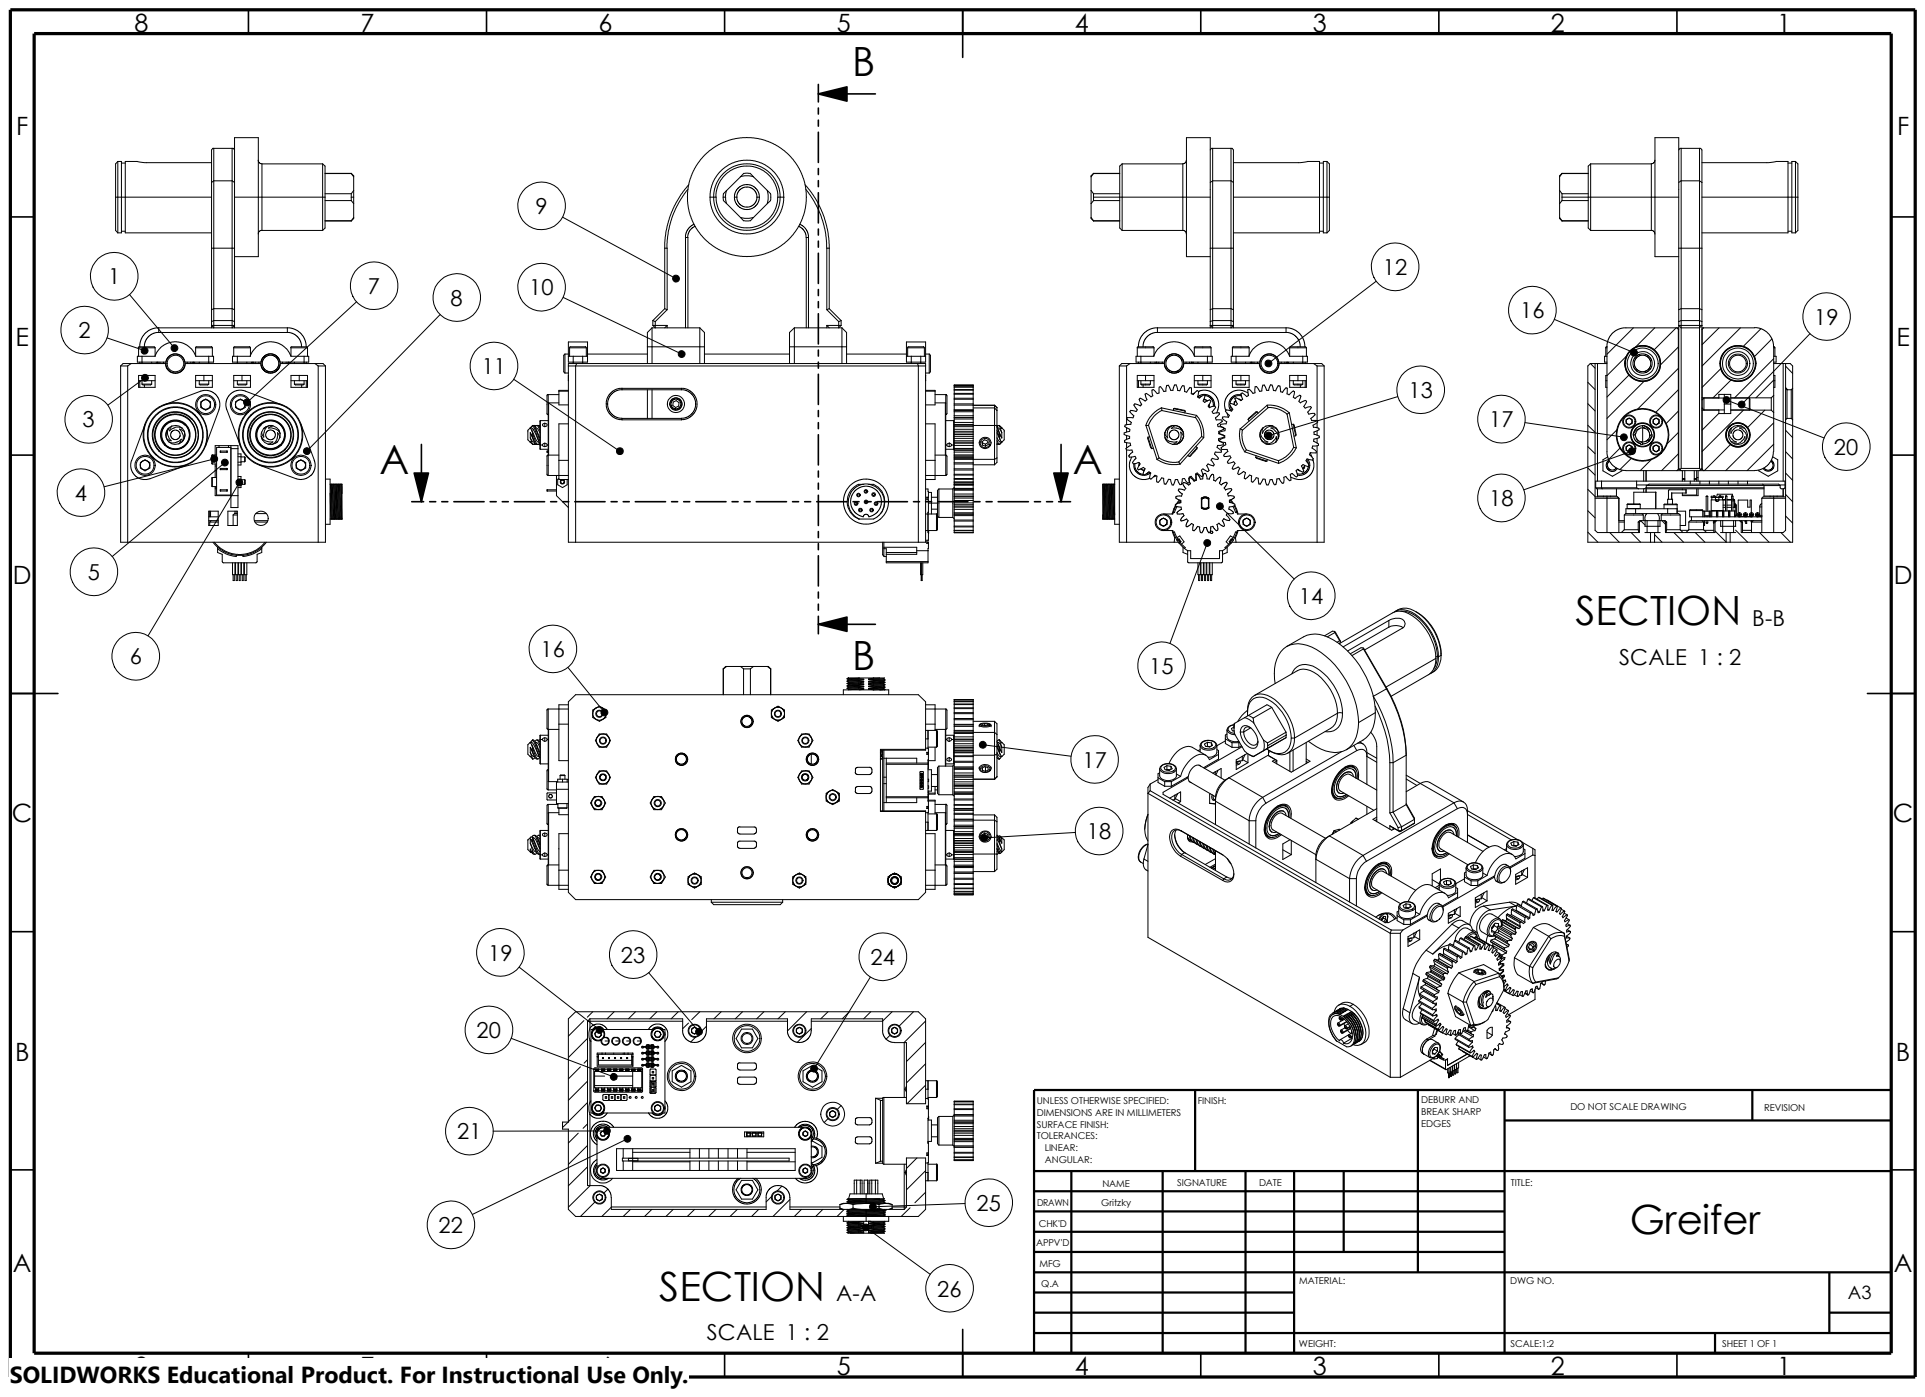
[picture p49: page 1]
SCALE:1:2; SHEET 1 OF 1; WEIGHT:; REVISION; FINISH:; EDGES; DEBURR AND BREAK SHARP; SCALE 1 : 2; SECTION; SECTION B-B

UNLESS OTHERWISE SPECIFIED:
DIMENSIONS ARE IN MILLIMETERS
SURFACE FINISH:
TOLERANCES:
LINEAR:
ANGULAR:

DO NOT SCALE DRAWING

NAME | SIGNATURE | DATE | | | | TITLE: Greifer

DRAWN | Gritzky
CHK'D
APPV'D
Q.A | | | | MATERIAL: | DWG NO. | A3

MFG

SOLIDWORKS Educational Product. For Instructional Use Only.
